snovalleypa/SVPA-FloodSensor-2016/hardware/Access-Vent Hole.jpg

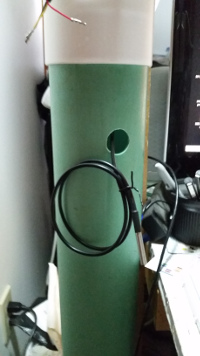
hardware/Access-Vent Hole.jpg
