snovalleypa/SVPA-FloodSensor-2016/README.md

# SVPA-FloodSensor-2016
Particle.io Electron reading a MaxBotix I2CXL-MaxSonar via the I2C bus and pushing the data to the cloud, both as Particle.io events and to data.sparkfun.com. Supporting the 2016-2017 deployment of prototype flood sensors by the Snoqualmie Valley Preservation Alliance.
