snovalleypa/SVPA-FloodSensor-2016/hardware/v0.2/2017-07-10 -- Design Review/electron_v020.brd

## EAGLE design hardware/v0.2/2017-07-10 -- Design Review/electron_v020.brd (2017-09-17)

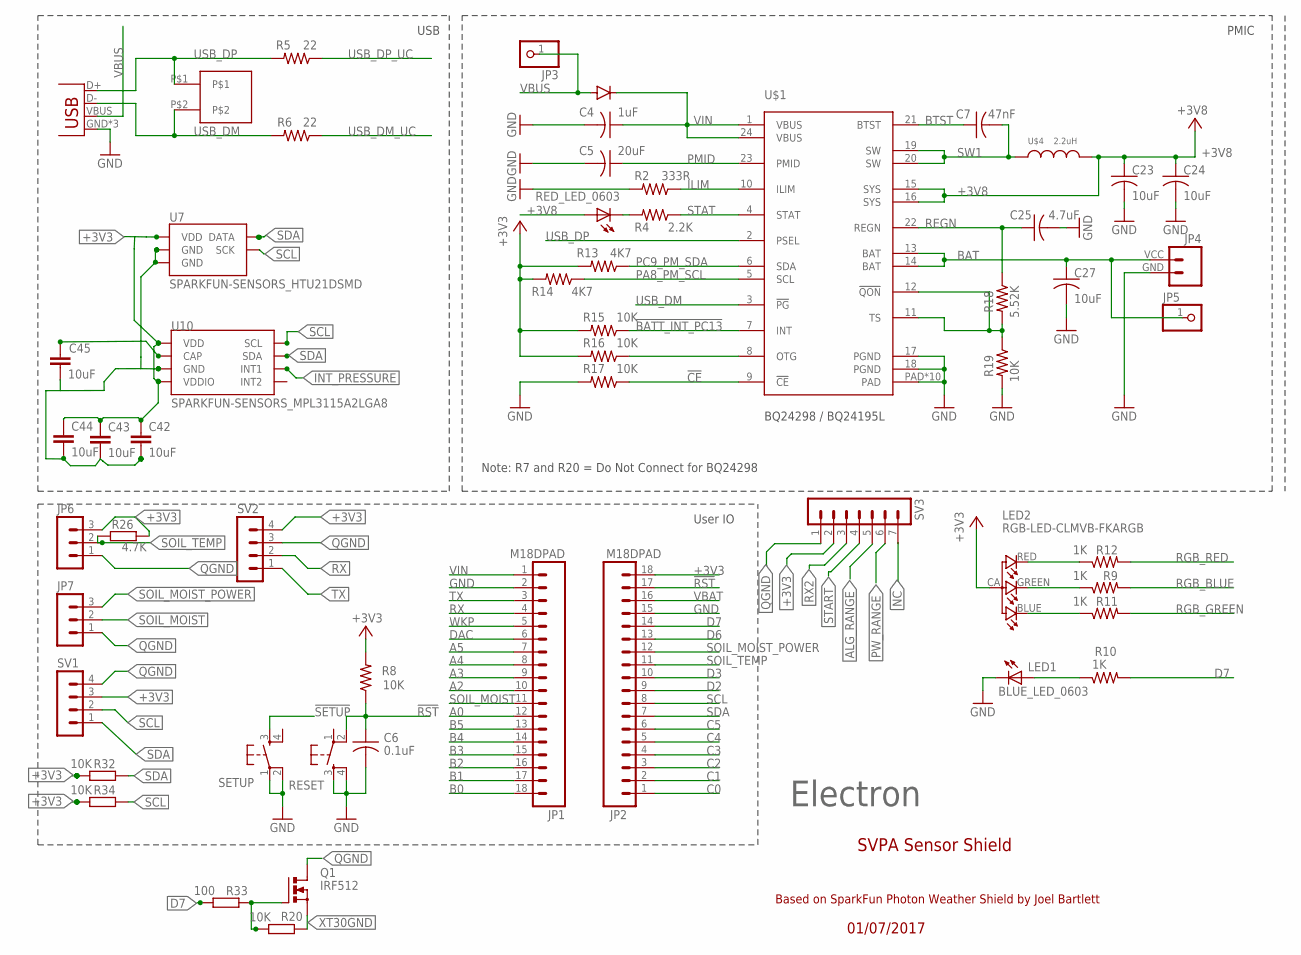
[picture p2: schematic electron_v020.sch, sheet 1]

Parts:
BLUE_LED_0603: LEDNOSILK; LED-0603-NS
C4: 1uF; C0603_B
C5: 20uF; C0603_B
C6: 0.1uF; C0402_B
C7: 47nF; C0402_B
C23, C24, C27: 10uF; C0603_B
C25: 4.7uF; C0603_B
C42, C43, C44, C45: 10uF; C0805
JP1, JP2: M18DPAD; 1X18-D-PADS
JP3, JP5: PINHD-1X1NOSILK; 1X01_NO_SILK
JP4: M024UCON-15767; JST-2-SMD-VERT
JP6, JP7: MA03-1
LED2: RGB-LED-CLMVB-FKARGB; PLCC4-2MM-RGB
Q1: IRF512; TO220BV
R2: 333R; R0402_B
R4: 2.2K; R0402_B
R5, R6: 22; R0402_B
R8, R15, R16, R17, R19: 10K; R0402_B
R9, R10, R11, R12: 1K; R0402_B
R13, R14: 4K7; R0402_B
R18: 5.52K; R0402_B
R20, R32, R34: 10K; R0805
R26: 4.7K; R0805
R33: 100; R0805
RED_LED_0603: LED0603; LED-0603
RESET: KMR211GLFS; TACTILE_SWITCH_SMD
SETUP: KMR211GLFS; TACTILE_SWITCH_SMD
SV1, SV2: MA04-1
SV3: MA07-1
U7: SPARKFUN-SENSORS_HTU21DSMD; SPARKFUN-SENSORS_HTU21D
U10: SPARKFUN-SENSORS_MPL3115A2LGA8; SPARKFUN-SENSORS_LGA8
U$1: BQ24298 / BQ24195L; QFN24
U$3: DIODE_NT; DIODE-DO-220AA_NT(SMP)
U$4: 2.2uH; 4020TYPE_NT
U$7: M02_0.05_HEADER
X1: USB-MICROB; USB-MICROB-SLOT-HOLE

Connections:
!BATT_INT_PC13: R15.1, U$1.7 (INT); also elsewhere on the board
!CE: R17.1, U$1.9 (!CE)
!RST: C6.1, JP2.17, R8.1, RESET.2; also elsewhere on the board
!SETUP: SETUP.3; also elsewhere on the board
+3V3: C42.1, C43.1, C44.1, JP2.18, JP6.3, LED2.CA (1), R8.2, R13.2, R14.2, R15.2, R16.2, R32.1, R34.1, SV1.3, SV2.4, U7.VDD, U10.1 (VDD), U10.4 (VDDIO); also elsewhere on the board
+3V8: C23.1, C24.1, RED_LED_0603.A, U$1.15 (SYS), U$1.16 (SYS), U$4.P$2 (2); also elsewhere on the board
A0: JP1.12; also elsewhere on the board
A2: JP1.10; also elsewhere on the board
A3: JP1.9; also elsewhere on the board
A4: JP1.8; also elsewhere on the board
A5: JP1.7; also elsewhere on the board
B0: JP1.18; also elsewhere on the board
B1: JP1.17; also elsewhere on the board
B2: JP1.16; also elsewhere on the board
B3: JP1.15; also elsewhere on the board
B4: JP1.14; also elsewhere on the board
B5: JP1.13; also elsewhere on the board
BAT: C27.1, JP4.VCC (2), JP5.1, U$1.13 (BAT), U$1.14 (BAT); also elsewhere on the board
BTST: C7.1, U$1.21 (BTST)
C0: JP2.1; also elsewhere on the board
C1: JP2.2; also elsewhere on the board
C2: JP2.3; also elsewhere on the board
C3: JP2.4; also elsewhere on the board
C4: JP2.5; also elsewhere on the board
C5: JP2.6; also elsewhere on the board
D2: JP2.9; also elsewhere on the board
D3: JP2.10; also elsewhere on the board
D6: JP2.13; also elsewhere on the board
D7: JP2.14, R10.2, R33.1; also elsewhere on the board
DAC: JP1.6; also elsewhere on the board
ILIM: R2.1, U$1.10 (ILIM)
INT_PRESSURE: U10.6 (INT1)
LED1: BLUE_LED_0603.A, R10.1
unnamed: R4.2, RED_LED_0603.C
unnamed: R16.1, U$1.8 (OTG)
unnamed: C45.1, U10.2 (CAP)
unnamed: LED2.BLUE (2), R11.1
unnamed: LED2.GREEN (3), R9.1
unnamed: Q1.G, R20.1, R33.2
unnamed: LED2.RED (4), R12.1
PA8_PM_SCL: R14.1, U$1.5 (SCL); also elsewhere on the board
PC9_PM_SDA: R13.1, U$1.6 (SDA); also elsewhere on the board
PMID: C5.1, U$1.23 (PMID)
QGND: C42.2, C43.2, C44.2, JP6.1, JP7.1, Q1.D, SV1.4, SV2.3, U7.7 (GND), U7.GND, U10.3 (GND)
REGN: C25.1, R18.1, U$1.22 (REGN)
RGB_BLUE: R11.2; also elsewhere on the board
RGB_GREEN: R9.2; also elsewhere on the board
RGB_RED: R12.2; also elsewhere on the board
RX: JP1.4, SV2.2; also elsewhere on the board
SCL: JP2.8, R34.2, SV1.2, U7.SCK, U10.8 (SCL)
SDA: JP2.7, R32.2, SV1.1, U10.7 (SDA)
SOIL_MOIST: JP1.11, JP7.2
SOIL_MOIST_POWER: JP2.12, JP7.3
SOIL_TEMP: JP2.11, JP6.2
STAT: R4.1, U$1.4 (STAT)
SW1: C7.2, U$1.19 (SW), U$1.20 (SW), U$4.P$1 (1)
TS: R18.2, R19.1, U$1.11 (TS), U$1.12 (!QON)
TX: JP1.3, SV2.1; also elsewhere on the board
USB_DM: R6.2, U$1.3 (!PG), U$7.P$2, X1.D-
USB_DM_UC: R6.1; also elsewhere on the board
USB_DP: R5.2, U$1.2 (PSEL), U$7.P$1, X1.D+
USB_DP_UC: R5.1; also elsewhere on the board
VBAT: JP2.16; also elsewhere on the board
VBUS: JP3.1, U$3.ANODE, X1.VBUS
VIN: C4.1, JP1.1, U$1.1 (VBUS), U$1.24 (VBUS), U$3.CATHODE
WKP: JP1.5; also elsewhere on the board

Notes on the sheet:
PMIC
User IO
USB
Electron
Note: R7 and R20 = Do Not Connect for BQ24298
01/07/2017
SVPA Sensor Shield
Based on SparkFun Photon Weather Shield by Joel Bartlett

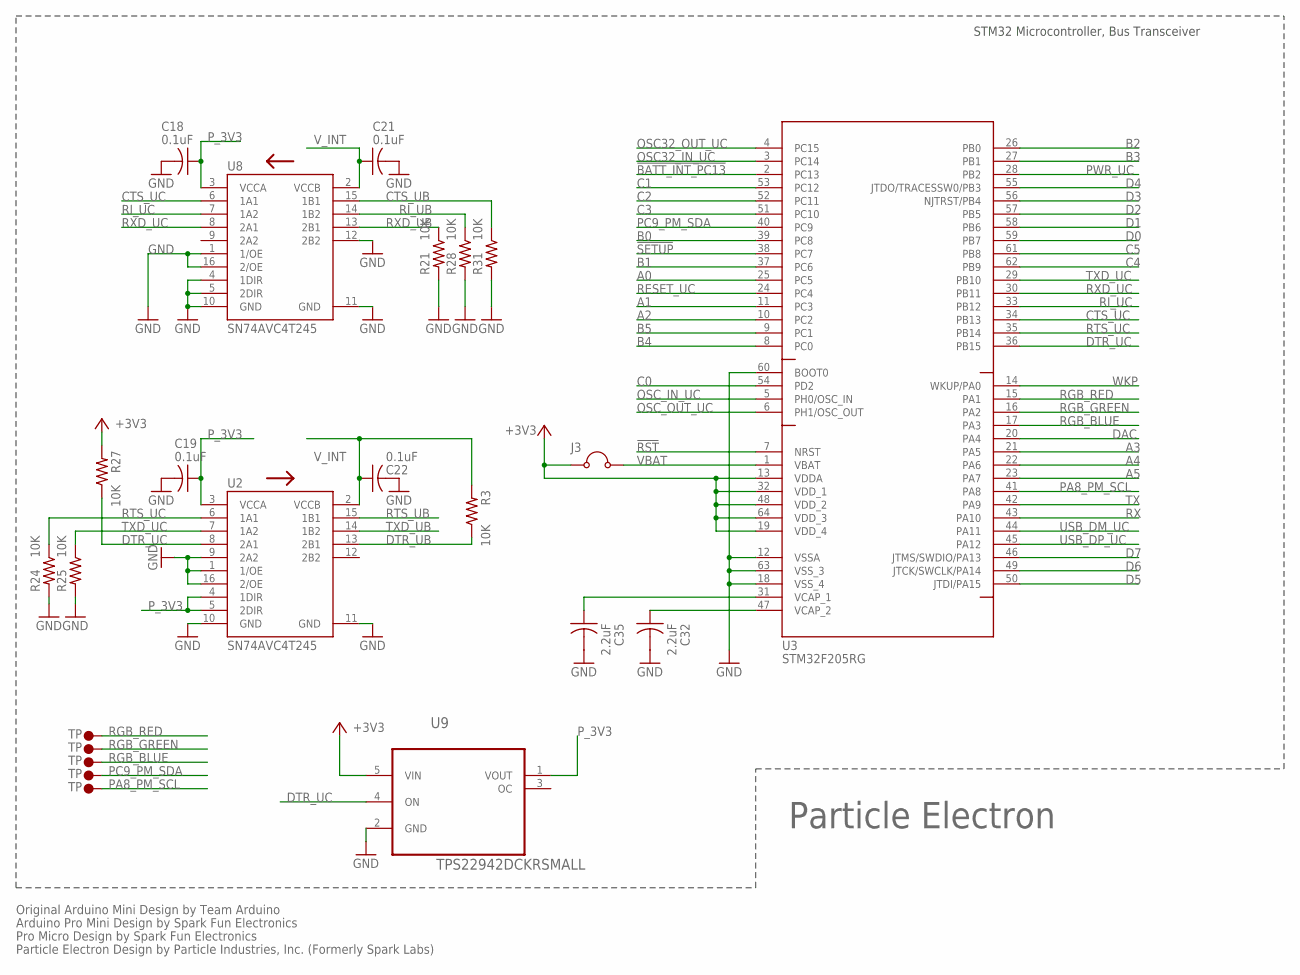
[picture p3: schematic electron_v020.sch, sheet 2]

Parts:
C18, C19, C21, C22: 0.1uF; C0402_B
C32, C35: 2.2uF; C0402_B
J3: JUMPER_NC_SMD; JUMPER_SMD_NC
R3, R21, R24, R25, R27, R28, R31: 10K; R0402_B
U2, U8: SN74AVC4T245; UFQFN-16
U3: STM32F205RG; LQFP64
U9: TPS22942DCKRSMALL; SC70-5
U$8, U$9, U$11, U$12, U$13: TP0; TP30_BOT

Connections:
!BATT_INT_PC13: U3.2 (PC13); also elsewhere on the board
!RST: U3.7 (NRST); also elsewhere on the board
!SETUP: U3.38 (PC7); also elsewhere on the board
+3V3: J3.1, R27.2, U3.13 (VDDA), U3.19 (VDD_4), U3.32 (VDD_1), U3.48 (VDD_2), U3.64 (VDD_3), U9.5 (VIN); also elsewhere on the board
A0: U3.25 (PC5); also elsewhere on the board
A1: U3.11 (PC3)
A2: U3.10 (PC2); also elsewhere on the board
A3: U3.21 (PA5); also elsewhere on the board
A4: U3.22 (PA6); also elsewhere on the board
A5: U3.23 (PA7); also elsewhere on the board
B0: U3.39 (PC8); also elsewhere on the board
B1: U3.37 (PC6); also elsewhere on the board
B2: U3.26 (PB0); also elsewhere on the board
B3: U3.27 (PB1); also elsewhere on the board
B4: U3.8 (PC0); also elsewhere on the board
B5: U3.9 (PC1); also elsewhere on the board
C0: U3.54 (PD2); also elsewhere on the board
C1: U3.53 (PC12); also elsewhere on the board
C2: U3.52 (PC11); also elsewhere on the board
C3: U3.51 (PC10); also elsewhere on the board
C4: U3.62 (PB9); also elsewhere on the board
C5: U3.61 (PB8); also elsewhere on the board
CTS_UB: R31.1, U8.15 (1B1); also elsewhere on the board
CTS_UC: U3.34 (PB13), U8.6 (1A1)
D0: U3.59 (PB7)
D1: U3.58 (PB6)
D2: U3.57 (PB5); also elsewhere on the board
D3: U3.56 (NJTRST/PB4); also elsewhere on the board
D4: U3.55 (JTDO/TRACESSW0/PB3)
D5: U3.50 (JTDI/PA15)
D6: U3.49 (JTCK/SWCLK/PA14); also elsewhere on the board
D7: U3.46 (JTMS/SWDIO/PA13); also elsewhere on the board
DAC: U3.20 (PA4); also elsewhere on the board
DTR_UB: R3.1, U2.13 (2B1); also elsewhere on the board
DTR_UC: R27.1, U2.8 (2A1), U3.36 (PB15), U9.4 (ON)
unnamed: C35.1, U3.31 (VCAP_1)
unnamed: C32.1, U3.47 (VCAP_2)
OSC32_IN_UC: U3.3 (PC14); also elsewhere on the board
OSC32_OUT_UC: U3.4 (PC15); also elsewhere on the board
OSC_IN_UC: U3.5 (PH0/OSC_IN); also elsewhere on the board
OSC_OUT_UC: U3.6 (PH1/OSC_OUT); also elsewhere on the board
PA8_PM_SCL: U3.41 (PA8), U$9.P$1; also elsewhere on the board
PC9_PM_SDA: U3.40 (PC9), U$8.P$1; also elsewhere on the board
PWR_UC: U3.28 (PB2); also elsewhere on the board
P_3V3: C18.1, C19.1, U2.3 (VCCA), U2.4 (1DIR), U2.5 (2DIR), U8.3 (VCCA), U9.1 (VOUT)
RESET_UC: U3.24 (PC4); also elsewhere on the board
RGB_BLUE: U3.17 (PA3), U$13.P$1; also elsewhere on the board
RGB_GREEN: U3.16 (PA2), U$12.P$1; also elsewhere on the board
RGB_RED: U3.15 (PA1), U$11.P$1; also elsewhere on the board
RI_UB: R28.1, U8.14 (1B2); also elsewhere on the board
RI_UC: U3.33 (PB12), U8.7 (1A2)
RTS_UB: U2.15 (1B1); also elsewhere on the board
RTS_UC: R24.1, U2.6 (1A1), U3.35 (PB14)
RX: U3.43 (PA10); also elsewhere on the board
RXD_UB: R21.1, U8.13 (2B1); also elsewhere on the board
RXD_UC: U3.30 (PB11), U8.8 (2A1)
TX: U3.42 (PA9); also elsewhere on the board
TXD_UB: U2.14 (1B2); also elsewhere on the board
TXD_UC: R25.1, U2.7 (1A2), U3.29 (PB10)
USB_DM_UC: U3.44 (PA11); also elsewhere on the board
USB_DP_UC: U3.45 (PA12); also elsewhere on the board
VBAT: J3.2, U3.1 (VBAT); also elsewhere on the board
V_INT: C21.1, C22.1, R3.2, U2.2 (VCCB), U8.2 (VCCB); also elsewhere on the board
WKP: U3.14 (WKUP/PA0); also elsewhere on the board

Notes on the sheet:
Particle Electron
STM32 Microcontroller, Bus Transceiver
Original Arduino Mini Design by Team Arduino
Arduino Pro Mini Design by Spark Fun Electronics
Pro Micro Design by Spark Fun Electronics
Particle Electron Design by Particle Industries, Inc. (Formerly Spark Labs)

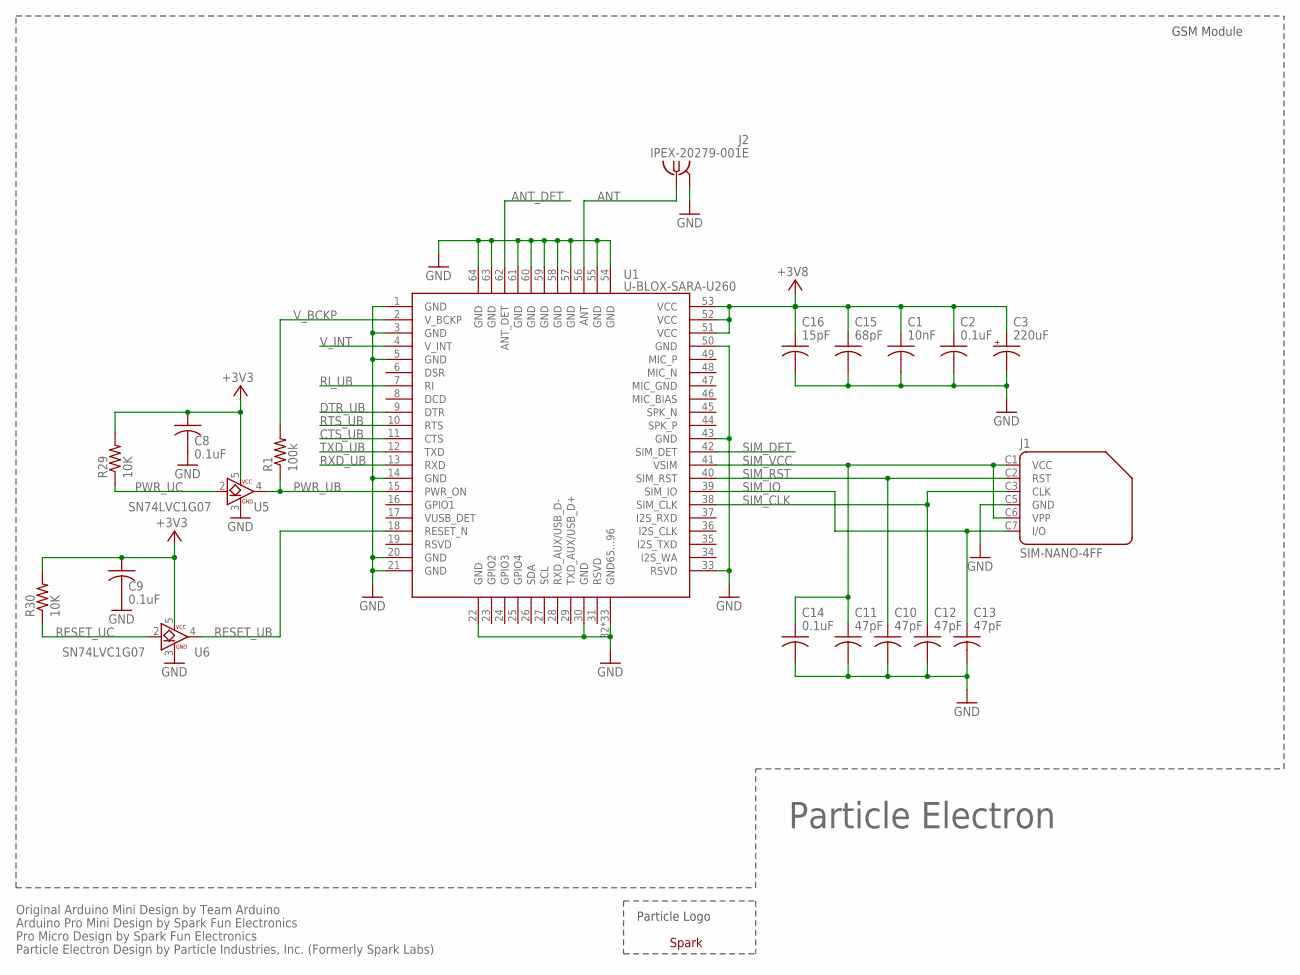
[picture p4: schematic electron_v020.sch, sheet 3]

Parts:
C1: 10nF; C0402_B
C2, C8, C9, C14: 0.1uF; C0402_B
C3: 220uF; C/6032-28R
C10, C11, C12, C13: 47pF; C0402_B
C15: 68pF; C0402_B
C16: 15pF; C0402_B
J1: SIM-NANO-4FF; GCT-SIM8100
J2: IPEX-20279-001E
R1: 100k; R0402_B
R29, R30: 10K; R0402_B
U1: U-BLOX-SARA-U260; U-BLOX-SARA-U2
U5, U6: SN74LVC1G07; SC-70-5
U$2: SPARK_LOGO2

Connections:
+3V3: C8.1, C9.1, R29.2, R30.2, U5.5 (VCC), U6.5 (VCC); also elsewhere on the board
+3V8: C1.1, C2.1, C3.+, C15.1, C16.1, U1.51 (VCC), U1.52 (VCC), U1.53 (VCC); also elsewhere on the board
ANT: J2.1, U1.56 (ANT)
ANT_DET: U1.62 (ANT_DET)
CTS_UB: U1.11 (CTS); also elsewhere on the board
DTR_UB: U1.9 (DTR); also elsewhere on the board
PWR_UB: R1.1, U1.15 (PWR_ON), U5.4 (B)
PWR_UC: R29.1, U5.2 (A); also elsewhere on the board
RESET_UB: U1.18 (RESET_N), U6.4 (B)
RESET_UC: R30.1, U6.2 (A); also elsewhere on the board
RI_UB: U1.7 (RI); also elsewhere on the board
RTS_UB: U1.10 (RTS); also elsewhere on the board
RXD_UB: U1.13 (RXD); also elsewhere on the board
SIM_CLK: C12.1, J1.C3 (CLK), U1.38 (SIM_CLK)
SIM_DET: U1.42 (SIM_DET)
SIM_IO: C13.1, J1.C7 (I/O), U1.39 (SIM_IO)
SIM_RST: C10.1, J1.C2 (RST), U1.40 (SIM_RST)
SIM_VCC: C11.1, C14.1, J1.C1 (VCC), J1.C6 (VPP), U1.41 (VSIM)
TXD_UB: U1.12 (TXD); also elsewhere on the board
V_BCKP: R1.2, U1.2 (V_BCKP)
V_INT: U1.4 (V_INT); also elsewhere on the board

Notes on the sheet:
Particle Electron
GSM Module
Particle Logo
Original Arduino Mini Design by Team Arduino
Arduino Pro Mini Design by Spark Fun Electronics
Pro Micro Design by Spark Fun Electronics
Particle Electron Design by Particle Industries, Inc. (Formerly Spark Labs)

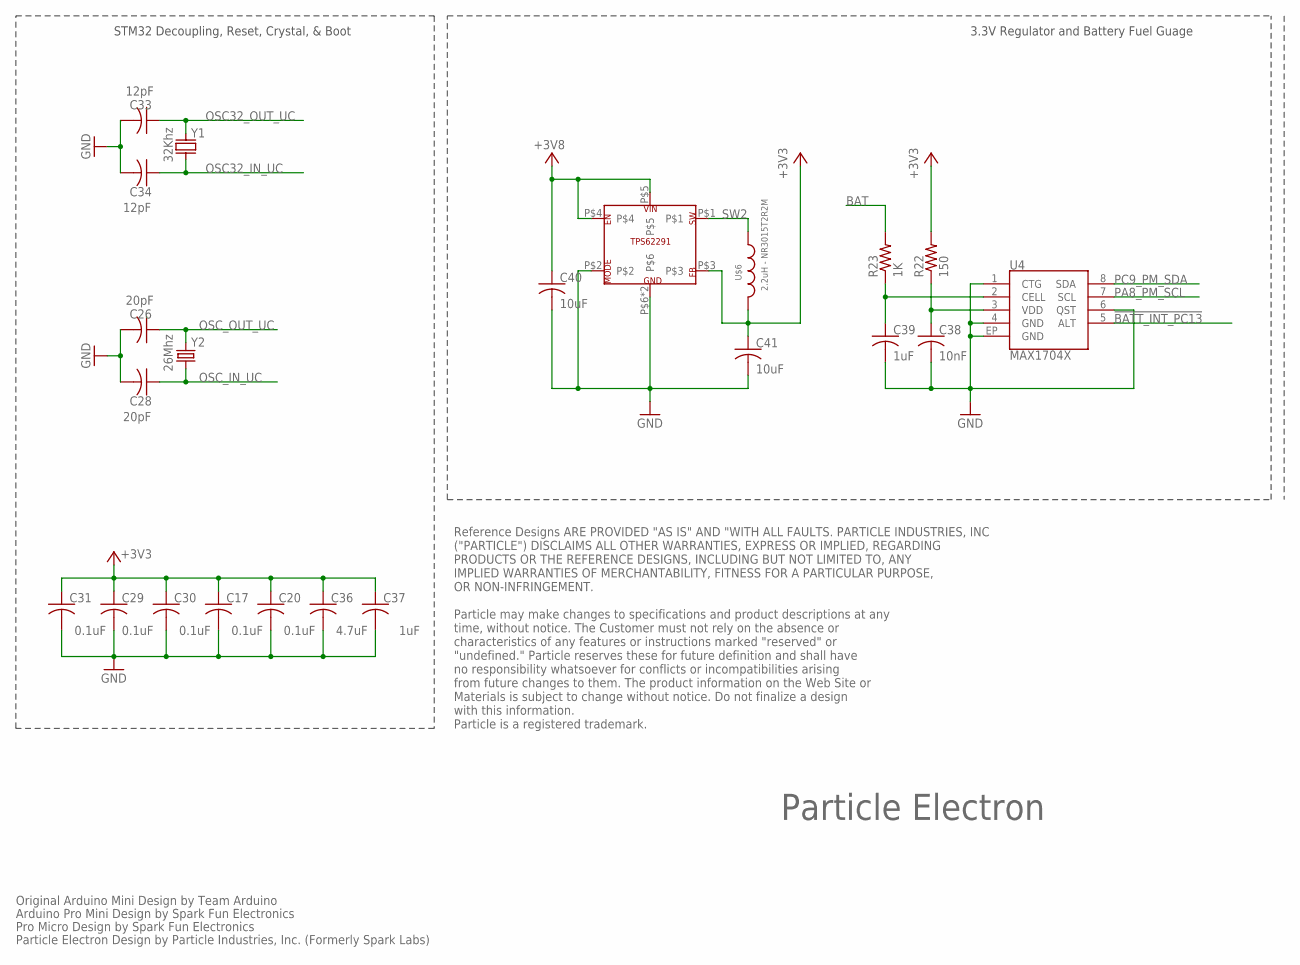
[picture p5: schematic electron_v020.sch, sheet 4]

Parts:
C17, C20, C29, C30, C31: 0.1uF; C0402_B
C26, C28: 20pF; C0402_B
C33, C34: 12pF; C0402_B
C36: 4.7uF; C0402_B
C37, C39: 1uF; C0402_B
C38: 10nF; C0402_B
C40, C41: 10uF; C0603_B
R22: 150; 0603-RES
R23: 1K; 0603-RES
U4: MAX1704X; TDFN-8
U$5: TPS62291DRV; S-PWSON-N6
U$6: 2.2uH - NR3015T2R2M; INDUCTOR-NR3015
Y1: 32Khz; FC135
Y2: 26Mhz; CRYSTAL-SMD-5X3

Connections:
!BATT_INT_PC13: U4.5 (ALT); also elsewhere on the board
+3V3: C17.1, C20.1, C29.1, C30.1, C31.1, C36.1, C37.1, C41.1, R22.2, U$5.P$3, U$6.2; also elsewhere on the board
+3V8: C40.1, U$5.P$4, U$5.P$5; also elsewhere on the board
BAT: R23.2; also elsewhere on the board
unnamed: C39.1, R23.1, U4.2 (CELL)
unnamed: C38.1, R22.1, U4.3 (VDD)
OSC32_IN_UC: C34.1, Y1.X1 (1); also elsewhere on the board
OSC32_OUT_UC: C33.1, Y1.X2 (2); also elsewhere on the board
OSC_IN_UC: C28.1, Y2.1; also elsewhere on the board
OSC_OUT_UC: C26.1, Y2.3 (2); also elsewhere on the board
PA8_PM_SCL: U4.7 (SCL); also elsewhere on the board
PC9_PM_SDA: U4.8 (SDA); also elsewhere on the board
SW2: U$5.P$1, U$6.1

Notes on the sheet:
Particle Electron
STM32 Decoupling, Reset, Crystal, & Boot
3.3V Regulator and Battery Fuel Guage
Original Arduino Mini Design by Team Arduino
Arduino Pro Mini Design by Spark Fun Electronics
Pro Micro Design by Spark Fun Electronics
Particle Electron Design by Particle Industries, Inc. (Formerly Spark Labs)
Reference Designs ARE PROVIDED "AS IS" AND "WITH ALL FAULTS. PARTICLE INDUSTRIES, INC ("PARTICLE") DISCLAIMS ALL OTHER WARRANTIES, EXPRESS OR IMPLIED, REGARDING PRODUCTS OR THE REFERENCE DESIGNS, INCLUDING BUT NOT LIMITED TO, ANY IMPLIED WARRANTIES OF MERCHANTABILITY, FITNESS FOR A PARTICULAR PURPO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
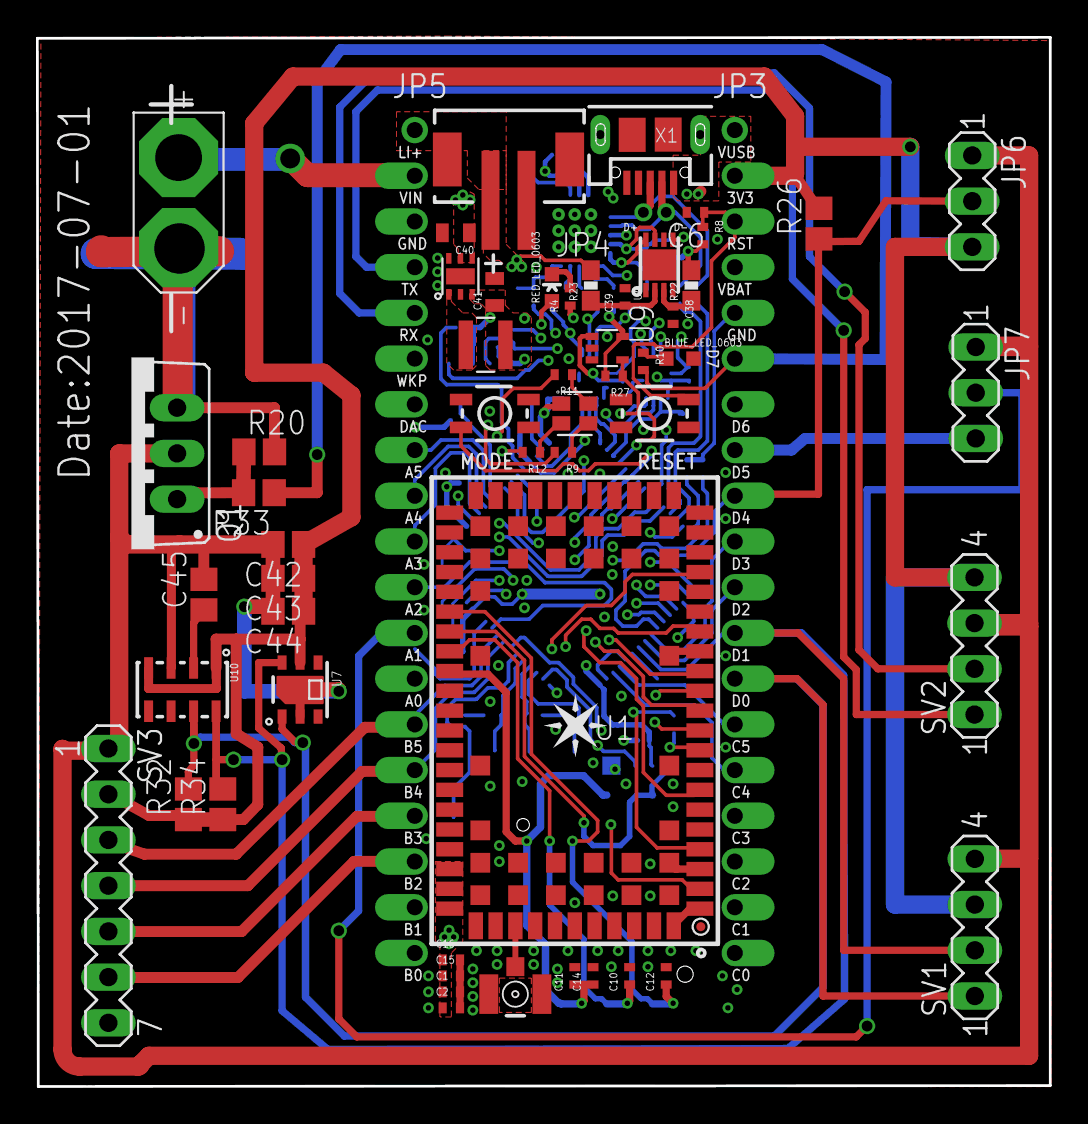
[picture p6: board electron_v020.brd from above]

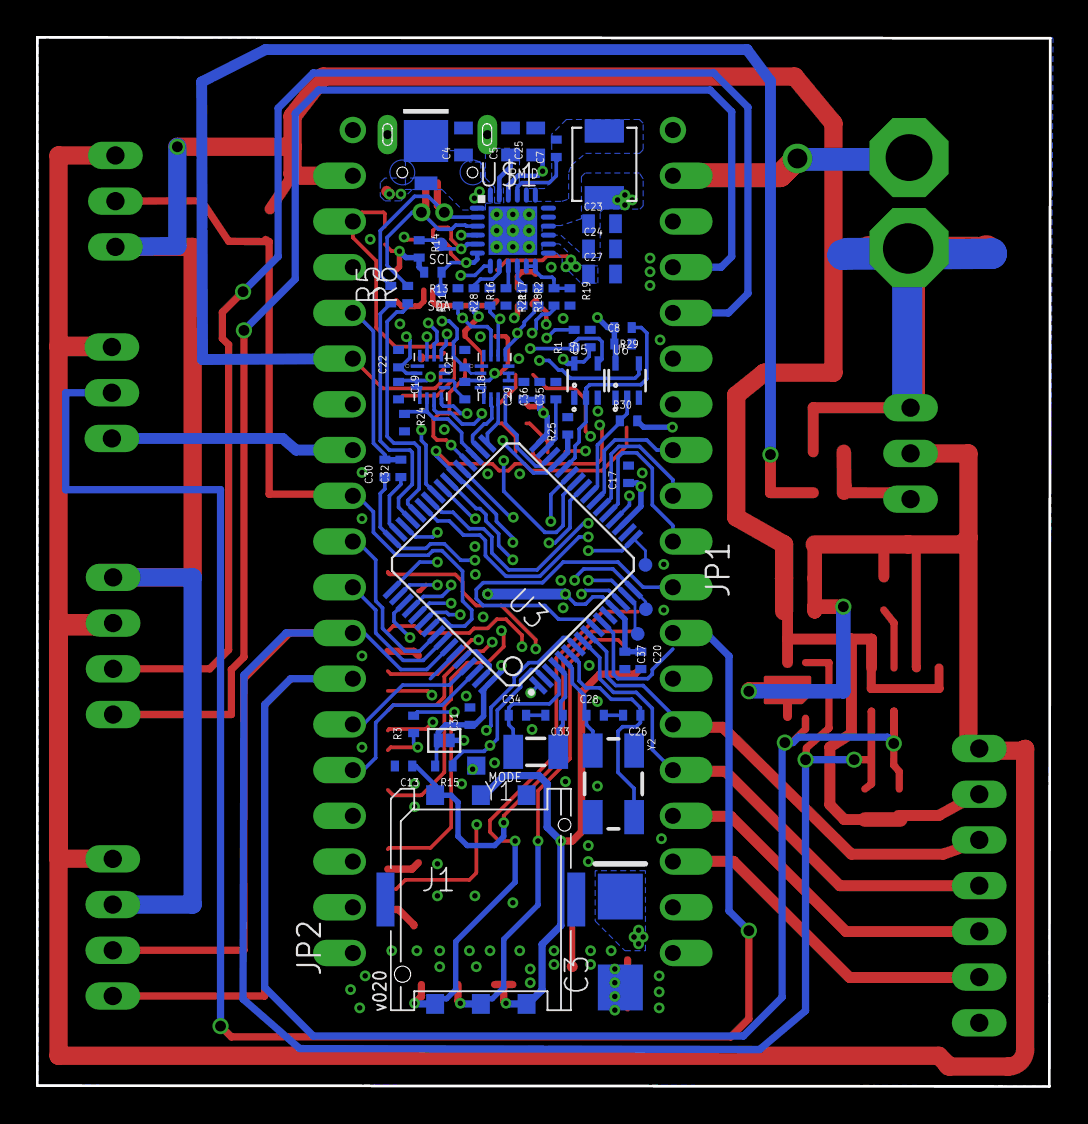
[picture p7: board electron_v020.brd from below]

Board: 4 copper layers, 56.3 x 58.3 mm, 123 parts (61 on the bottom side), 99 nets.

Other parts of the board:
E$1: HSPALM_XT30
