snovalleypa/SVPA-FloodSensor-2016/(commit log)

2016-10-02 Initial public commit of fork from https://github.com/tsayles/Photon-I2C-RangeFinder.git with changes to support Particle.io Electron.
2016-11-19 started dev branch; added prototype for functionality to ensure OTA updates; started refactoring of main module to facilitate multi developer activities;
2016-11-28 Added status webpage files (work in progress)
    [Devices.csv]
2016-12-23 refactored plotSensorData as a function and plot a 2nd device
2017-01-12 updated devices.csv with Unit-01-Tom-WiFi for web page
    [Devices.csv]
2017-01-15 resyncing with live MPZap.com website
    [Devices.csv]
2017-01-15 updates to include filtered links to Readings stream at data.SparkFun.com
    [Devices.csv]
2017-02-19 improved POST reliability. Added call to saveNewReading. Cleaned up old / irrelavant comments.
    [Devices.csv]
2017-07-05 updated firmwareVersion to 13; also added LED flashes after data collected and before radio start
2017-08-03 adding v020 hardware files and HW reference files
    [SVPA-Flood_Sensor_Shield_v020.sch, electron_v020.brd, electron_v020.sch]
2017-09-17 HTML & js Updates to pull live device list from Particle.io. Working on live event stream.
    [Devices.csv]
2017-09-17 cleaning up working folders (ignoring z_Archives folders) and adding hardware related files.
    [SDI-12_interface.sch]
